soulfll/quickie/README.md

# Quick-Key
quick key is a project for streamlining work
