soulfll/quickie/hardware/new project v.3 new layout.kicad_pcb

## KiCad design hardware/new project v.3 new layout.kicad_pcb (2026-08-28)

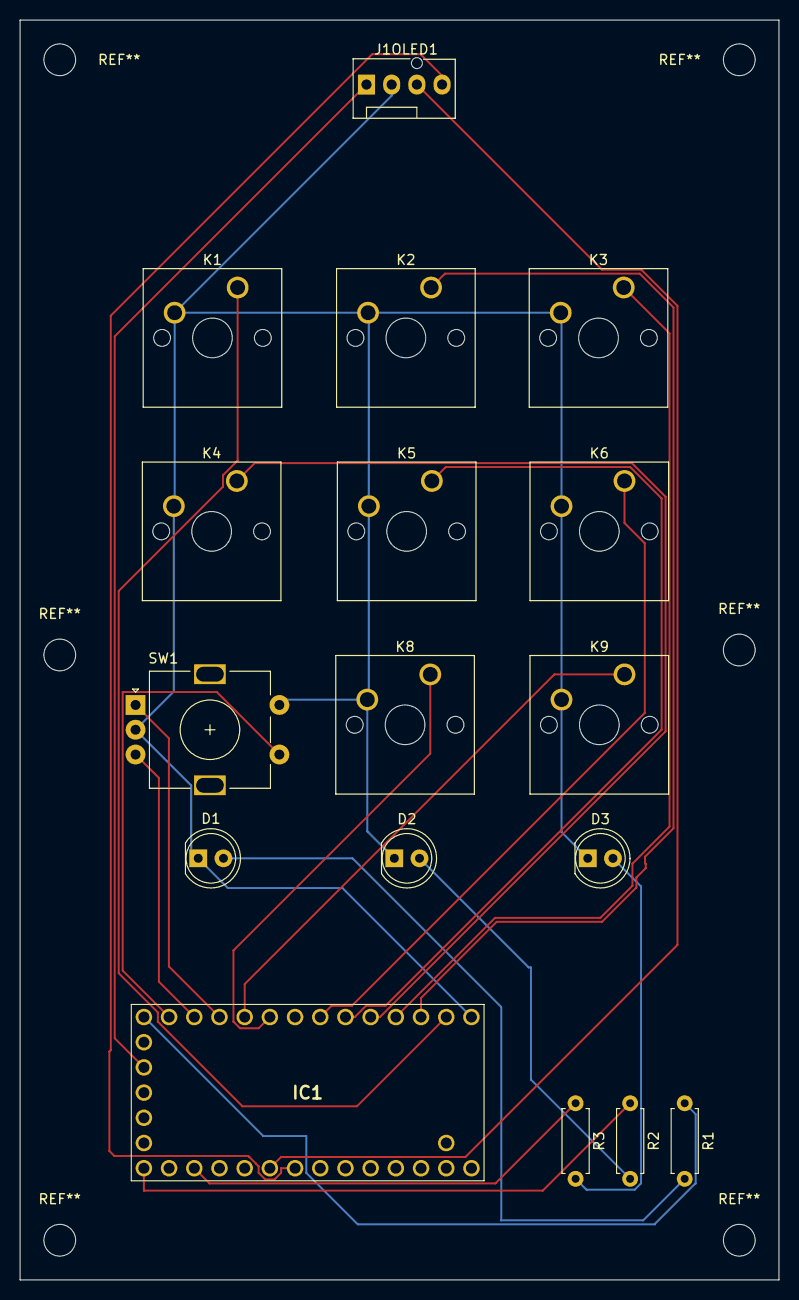
[picture p1: board new project v.3 new layout.kicad_pcb from above]

Board: 2 copper layers, 76.5 x 127.0 mm, 17 parts (0 on the bottom side), 21 nets.

Parts:
D1, D2, D3: LED; LED_D5.0mm
IC1: TEENSY_4.0; TEENSY40
J1OLED1: Conn_01x04; FanPinHeader_1x04_P2.54mm_Vertical
K1, K2, K3, K4, K5, K6, K8, K9: SW_Push; SW_Cherry_MX_1.00u_PCB
R1, R2, R3: R; R_Axial_DIN0207_L6.3mm_D2.5mm_P7.62mm_Horizontal
SW1: RotaryEncoder_Switch; RotaryEncoder_Alps_EC11E-Switch_Vertical_H20mm

Connections:
/Teensy 10: IC1.12 (10), SW1.B
/oled scl: IC1.26 (19), J1OLED1.4
/oled sda: IC1.25 (18), J1OLED1.3
/teensy 15 red led: IC1.22 (15), R3.1
/vcc oled: IC1.16 (3.3V), J1OLED1.1
GND: D1.1 (K), D2.1 (K), D3.1 (K), IC1.1 (GND_1), J1OLED1.2, K1.2, K2.2, K3.2, K4.2, K5.2, K6.2, K8.2, K9.2, SW1.C, SW1.S2
unnamed: D1.2 (A), R1.2
unnamed: D2.2 (A), R2.2
unnamed: D3.2 (A), R3.2
unnamed: IC1.2 (0), K1.1
unnamed: IC1.3 (1), K2.1
unnamed: IC1.4 (2), K3.1
unnamed: IC1.5 (3), K4.1
unnamed: IC1.6 (4), K5.1
unnamed: IC1.7 (5), K6.1
unnamed: IC1.9 (7), K8.1
unnamed: IC1.10 (8), K9.1
unnamed: IC1.11 (9), SW1.A
unnamed: IC1.13 (11), SW1.S1
unnamed: IC1.14 (12), R1.1
unnamed: IC1.20 (13), R2.1
