soulfll/quickie/(commit log)

2026-08-14 initial: blink working on Teensy 4.0, platformio config
2026-08-14 firmware: 8 direct keys + rotary encoder -> F13-F23 HID codes, RGB status LED, OLED display scaffold
2026-08-14 companion-app: Python/Tkinter frontend, global F13-F23 listener, per-slot multi-app launcher
2026-08-28 firmware: real pin assignments from PCB (keys 0-5,7,8; encoder 9-11), stub out RGB pending real LED wiring
    [new project v.3 new layout.kicad_pcb]
2026-09-04 companion-app: assign-via-keypress with confirm/cancel, multi-profile support
    - New action model: each slot holds a list of {type, value} actions
    instead of bare paths -- supports app launch, website open, and typed
    text snippets, with automatic migration of old configs
    - action_picker.py: shared 'what should this key do' popup used by both
    the manual Add... button and assign-via-keypress, so the picker only
    costs an extra click at assign time, never at runtime
    - Windows app picker now defaults to the Start Menu Programs folder with
    proper file-type filters instead of browsing raw folders
    - launcher.py dispatches by action type: app launch (OS-specific),
    website (stdlib webbrowse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
2026-10-16 firmware: drive 2.08in SH1122 SPI OLED via U8g2 (CS16 DC17 RST20), verified on hardware
    - display.cpp rewritten for the 256x64 SPI module; SCL/SDA on the PCB header
    (pins 19/18) are used as software-SPI clock/data, RST/DC/CS are jumper wires
    - platformio.ini: swap Adafruit SSD1306/GFX/BusIO for olikraus/U8g2
    - rgb.cpp: correct the stub comment -- LEDs D1/D2/D3 are on pins 12/13/15
    through series resistors (earlier note wrongly said they were unrouted)
2026-10-16 firmware: add teensy40_v4 build target for the new PCB (keys on pins 0-7)
    Default env (teensy40) still builds the original v3 board. Flash the new
    board with: pio run -e teensy40_v4 -t upload. Verified on hardware: all 8
    keys and encoder rotation report, grid reads 0 1 [enc] / 2 3 4 / 5 6 7.
2026-10-16 firmware: display pins for the new PCB (DC 14, RST 15, CS 16), verified working
    Original v3 board keeps CS 16 / DC 17 / RST 20 via #ifdef BOARD_V4.
2026-10-17 docs: add landing page (static, GitHub Pages ready)
    Single-file site: hero with the device drawn in CSS, 3-step setup, what a
    key can do, privacy summary, FAQ. Download button points at the GitHub
    releases page until QuickieSetup.exe is published.
2026-10-19 firmware: profile/key-info screen, volume bar, volume-knob dial with bounce-proof decoder
    - Screen shows the active profile, short messages from the app (what a key
    does, each step of assigning a key) and an 18-segment volume bar. Frames are
    sent in full by a fast direct-pin transfer: U8g2's SH1122 driver only works
    with full-width sends, so partial updates scrambled the picture.
    - Dial is now a volume knob (turn = volume up/down, click = mute) using the
    standard media keys, so it works with no software installed. Rotation is
    decoded in an interrupt with a Gray-code accumulator, so contact bounce
    cancels out instead of counting as extra steps.
    - link.cpp: small line-based protoco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
2026-10-19 companion-app: Quick-Key rename, action picker, Record Keystrokes, device screen link, volume bar
    - Searchable installed-apps picker (replaces the file dialog that could not
    select .app bundles and moved the window on macOS); Cmd/Ctrl-click
    multi-select and multi-remove in key lists
    - Record Keystrokes: record a sequence and replay it with one press
    - device_link.py: finds the Quick-Key over serial and sends the active profile,
    per-step messages and the volume to its screen
    - volume_sync.py: reads the real system volume (CoreAudio on macOS, pycaw on
    Windows) when a volume key is seen; ~0.2 ms per read, so the bar feels instant
    - Dial is no longer an assignable slot (it is a volume kn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
2026-10-19 tools: OLED hardware test, and share the display pins in one header
    tools/oled_test cycles simple patterns (all on, all off, stripes, half, corner
    box, slow stripes) using only the pins and the screen's own startup commands,
    so a faulty wire can be told apart from a software problem. Flash with
    pio run -e oled_test_v4 -t upload. display_pins.h is now shared by the real
    firmware and the test.
2026-10-19 tools: wire-order finder for the OLED's CS/DC/RST wires; document what the tests found
